Greg-R/t41_2_low_power_amplifier/README.md

The documentation for this module is located here:

<https://kf5n.com/t41-2/low_power_amplifier/>
