Greg-R/t41_2_low_power_amplifier/doc/t41_2_low_power_amplifier.pdf

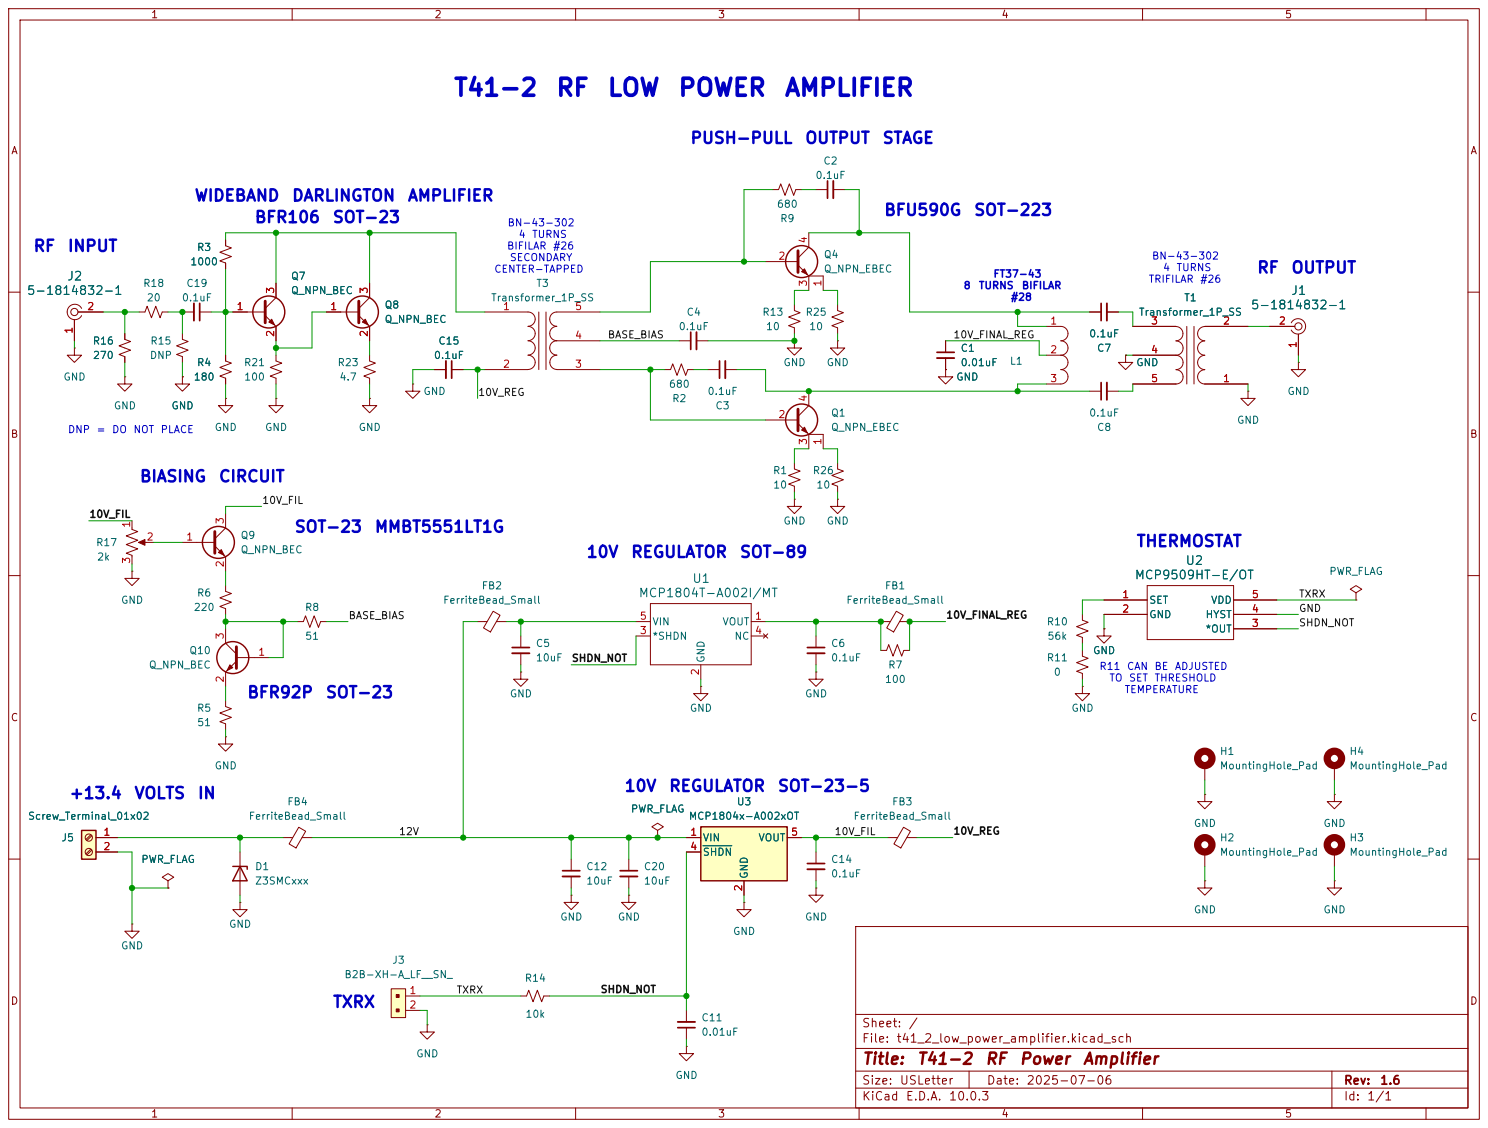
[picture p1: page 1]

T41-2 RF LOW POWER AMPLIFIER

PUSH-PULL OUTPUT STAGE
TXRX BN-43-302
4 TURNS
TRIFILAR #26

Sheet: /
File: t41_2_low_power_amplifier.kicad_sch
Title: T41-2 RF Power Amplifier

Size: USLetter | Rev: 1.6
KiCad E.D.A. 10.0.3 | Id: 1/1
