Greg-R/t41_2_low_power_amplifier/t41_2_low_power_amplifier.kicad_pcb

## KiCad design t41_2_low_power_amplifier.kicad_pcb (2026-07-03)

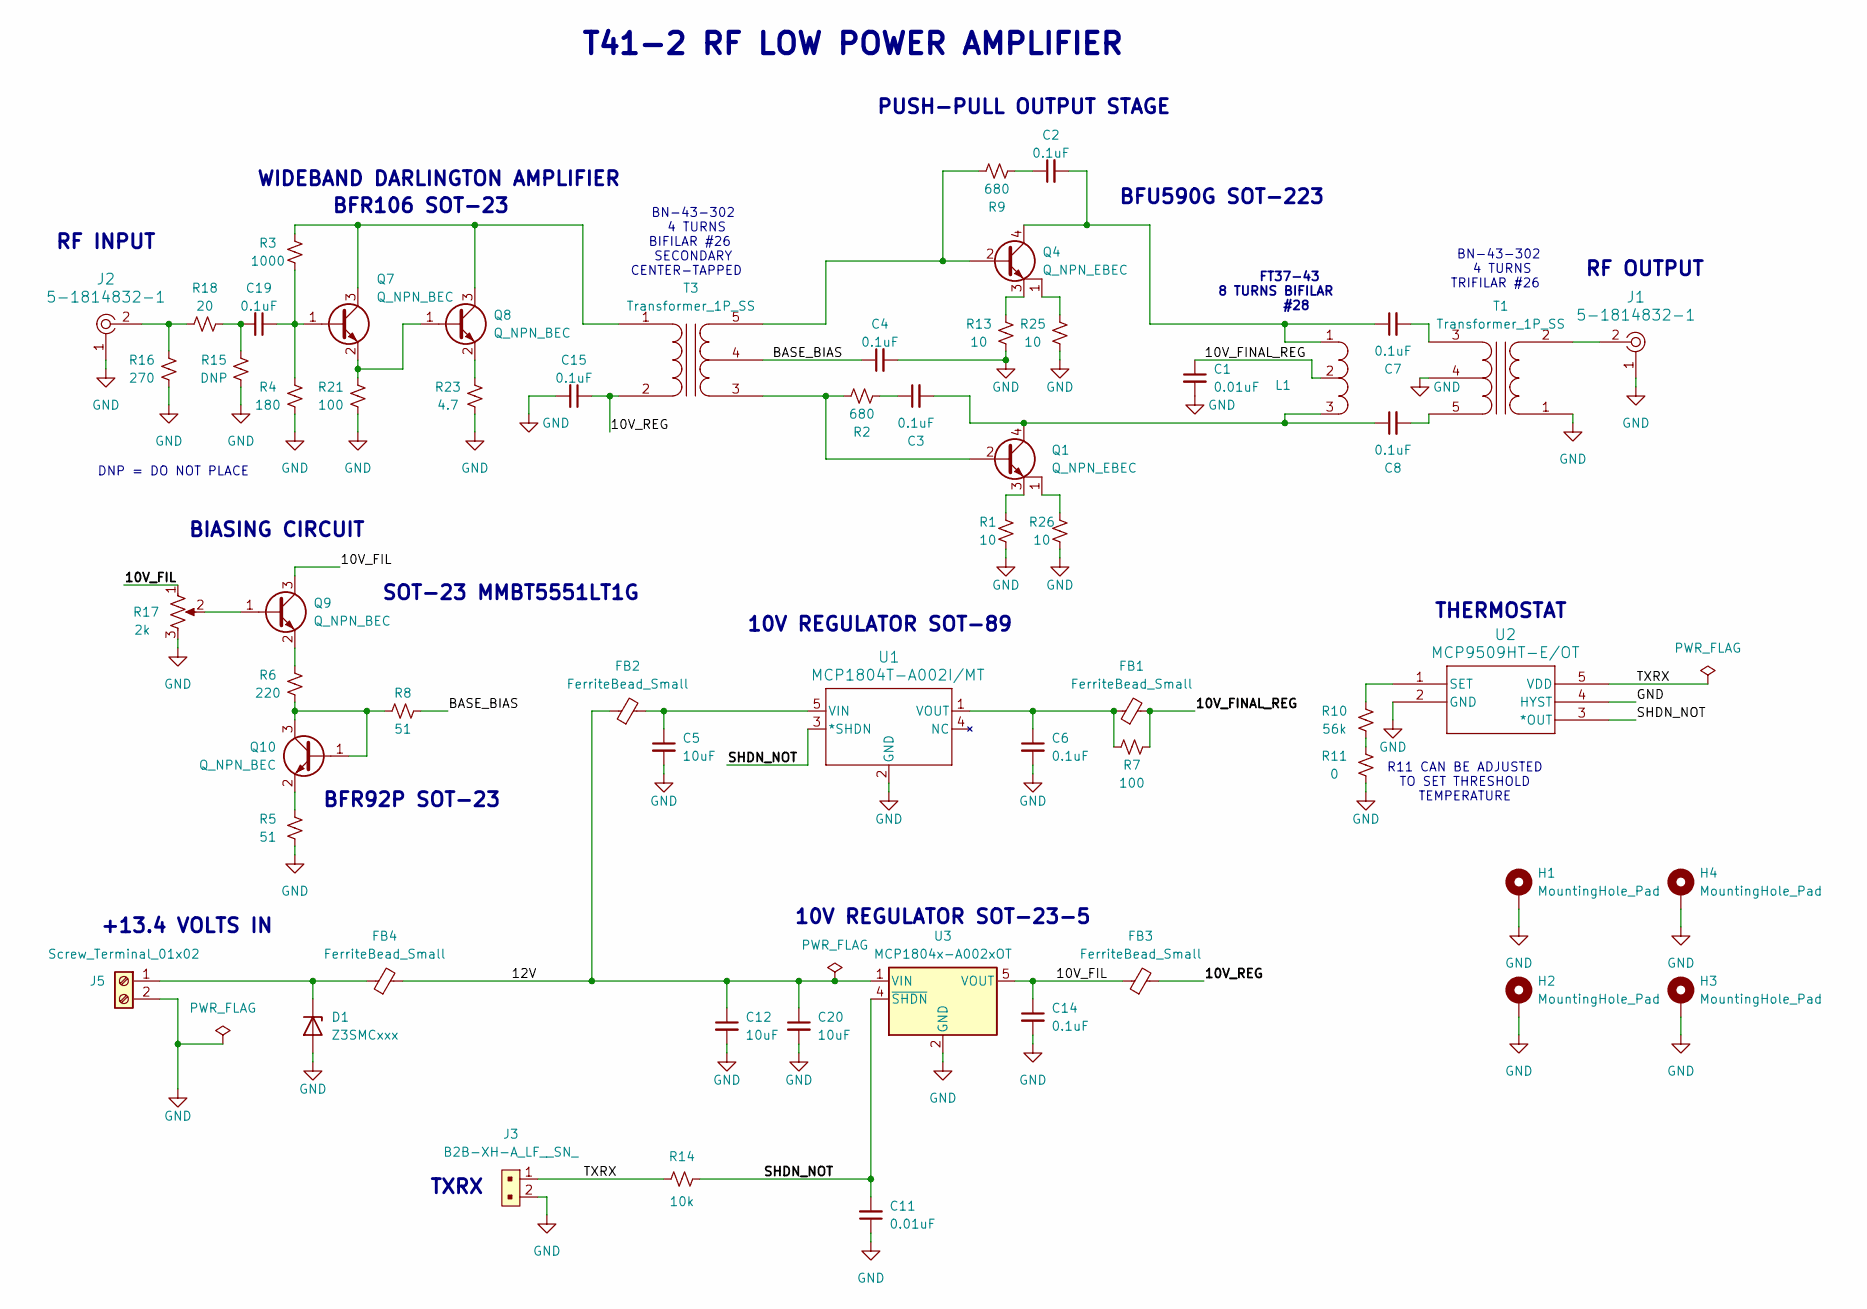
[picture p2: schematic t41_2_low_power_amplifier.kicad_sch, T41-2 RF Power Amplifier]

Parts:
C1, C11: 0.01uF; C_1206_3216Metric
C2, C3, C4, C6, C7, C8, C14, C15, C19: 0.1uF; C_1206_3216Metric
C5, C12, C20: 10uF; C_1206_3216Metric
D1: Z3SMCxxx; D_SMC
FB1, FB2, FB3, FB4: FerriteBead_Small; L_1206_3216Metric
H1, H2, H3, H4: MountingHole_Pad; MountingHole_4.3mm_M4_DIN965_Pad
J1, J2: 5-1814832-1; RF_SMA_Vertical_5-1814832-1; MPN 5-1814832-1; Digi-Key_PN A97594-ND
J3: B2B-XH-A_LF__SN_; PinHeader_1x2_P2.5mm_Drill1.1mm; MPN B2B-XH-A(LF)(SN); Digi-Key_PN 455-2247-ND
J5: Screw_Terminal_01x02; TerminalBlock_Philmore_TB132_1x02_P5.00mm_Horizontal
L1: FT37-43
Q1, Q4: Q_NPN_EBEC; SOT-223
Q7, Q8, Q9, Q10: Q_NPN_BEC; SOT-23-3
R1, R13, R25, R26: 10; R_1206_3216Metric
R2, R9: 680; R_1206_3216Metric
R3: 1000; R_1206_3216Metric
R4: 180; R_1206_3216Metric
R5, R8: 51; R_1206_3216Metric
R6: 220; R_1206_3216Metric
R7, R21: 100; R_1206_3216Metric
R10: 56k; R_1206_3216Metric
R11: 0; R_1206_3216Metric
R14: 10k; R_1206_3216Metric
R15: DNP; R_1206_3216Metric
R16: 270; R_1206_3216Metric
R17: 2k; Potentiometer_Bourns_3296W_Vertical
R18: 20; R_1206_3216Metric
R23: 4.7; R_1206_3216Metric
T1, T3: Transformer_1P_SS; BN-43-302_Vertical
U1: MCP1804T-A002I/MT; SOT-89_5MC_MCH
U2: MCP9509HT-E/OT; SOT-23-5_MC_MCH
U3: MCP1804x-A002xOT; SOT-23-5

Connections:
/10V_FIL: C14.1, FB3.1, Q9.3 (C), R17.1, U3.5 (VOUT)
/10V_FINAL_REG: C1.1, FB1.2, L1.2, R7.1
/10V_REG: C15.1, FB3.2, T3.2 (AB)
/12V: C12.1, C20.1, FB2.1, FB4.2, U3.1 (VIN)
/BASE_BIAS: C4.1, R8.1, T3.4 (SC)
/SHDN_NOT: C11.2, R14.2, U1.3 (*SHDN), U2.3 (*OUT), U3.4 (~SHDN)
/TXRX: J3.1, R14.1, U2.5 (VDD)
GND: C1.2, C4.2, C5.2, C6.2, C11.1, C12.2, C14.2, C15.2, C20.2, D1.2 (A), H1.1, H2.1, H3.1, H4.1, J1.1, J2.1, J3.2, J5.2, R1.1, R4.1, R5.1, R11.2, R13.1, R15.1, R16.1, R17.3, R21.1, R23.1, R25.1, R26.1, T1.1 (AA), T1.4 (SC), U1.2 (GND), U2.2 (GND), U2.4 (HYST), U3.2 (GND)
unnamed: C2.1, R9.1
unnamed: C3.1, R2.1
unnamed: C19.2, R15.2, R18.2
unnamed: D1.1 (K), FB4.1, J5.1
unnamed: J2.2, R16.2, R18.1
unnamed: Q1.2 (B), R2.2, T3.3 (SA)
unnamed: C3.2, C8.1, L1.3, Q1.4 (C)
unnamed: Q1.3 (E), R1.2
unnamed: Q1.1, R26.2
unnamed: Q4.2 (B), R9.2, T3.5 (SB)
unnamed: C2.2, C7.1, L1.1, Q4.4 (C)
unnamed: Q4.3 (E), R13.2
unnamed: Q4.1, R25.2
unnamed: C19.1, Q7.1 (B), R3.1, R4.2
unnamed: Q7.3 (C), Q8.3 (C), R3.2, T3.1 (AA)
unnamed: Q7.2 (E), Q8.1 (B), R21.2
unnamed: Q8.2 (E), R23.2
unnamed: Q9.1 (B), R17.2
unnamed: Q9.2 (E), R6.2
unnamed: Q10.1 (B), Q10.3 (C), R6.1, R8.2
unnamed: Q10.2 (E), R5.2
unnamed: R10.2, R11.1
unnamed: J1.2, T1.2 (AB)
unnamed: C7.2, T1.3 (SA)
unnamed: C8.2, T1.5 (SB)
unnamed: C5.1, FB2.2, U1.5 (VIN)
unnamed: C6.1, FB1.1, R7.2, U1.1 (VOUT)
unnamed: R10.1, U2.1 (SET)

Notes on the sheet:
RF OUTPUT
THERMOSTAT
PUSH-PULL OUTPUT STAGE
BN-43-302 4 TURNS TRIFILAR #26
R11 CAN BE ADJUSTED TO SET THRESHOLD TEMPERATURE
BFU590G SOT-223
BIASING CIRCUIT
SOT-23 MMBT5551LT1G
+13.4 VOLTS IN
TXRX
FT37-43 8 TURNS BIFILAR #28
DNP = DO NOT PLACE
T41-2 RF LOW POWER AMPLIFIER
BFR106 SOT-23
RF INPUT
10V REGULATOR SOT-23-5
BN-43-302 4 TURNS BIFILAR #26 SECONDARY CENTER-TAPPED
WIDEBAND DARLINGTON AMPLIFIER
BFR92P SOT-23
10V REGULATOR SOT-89

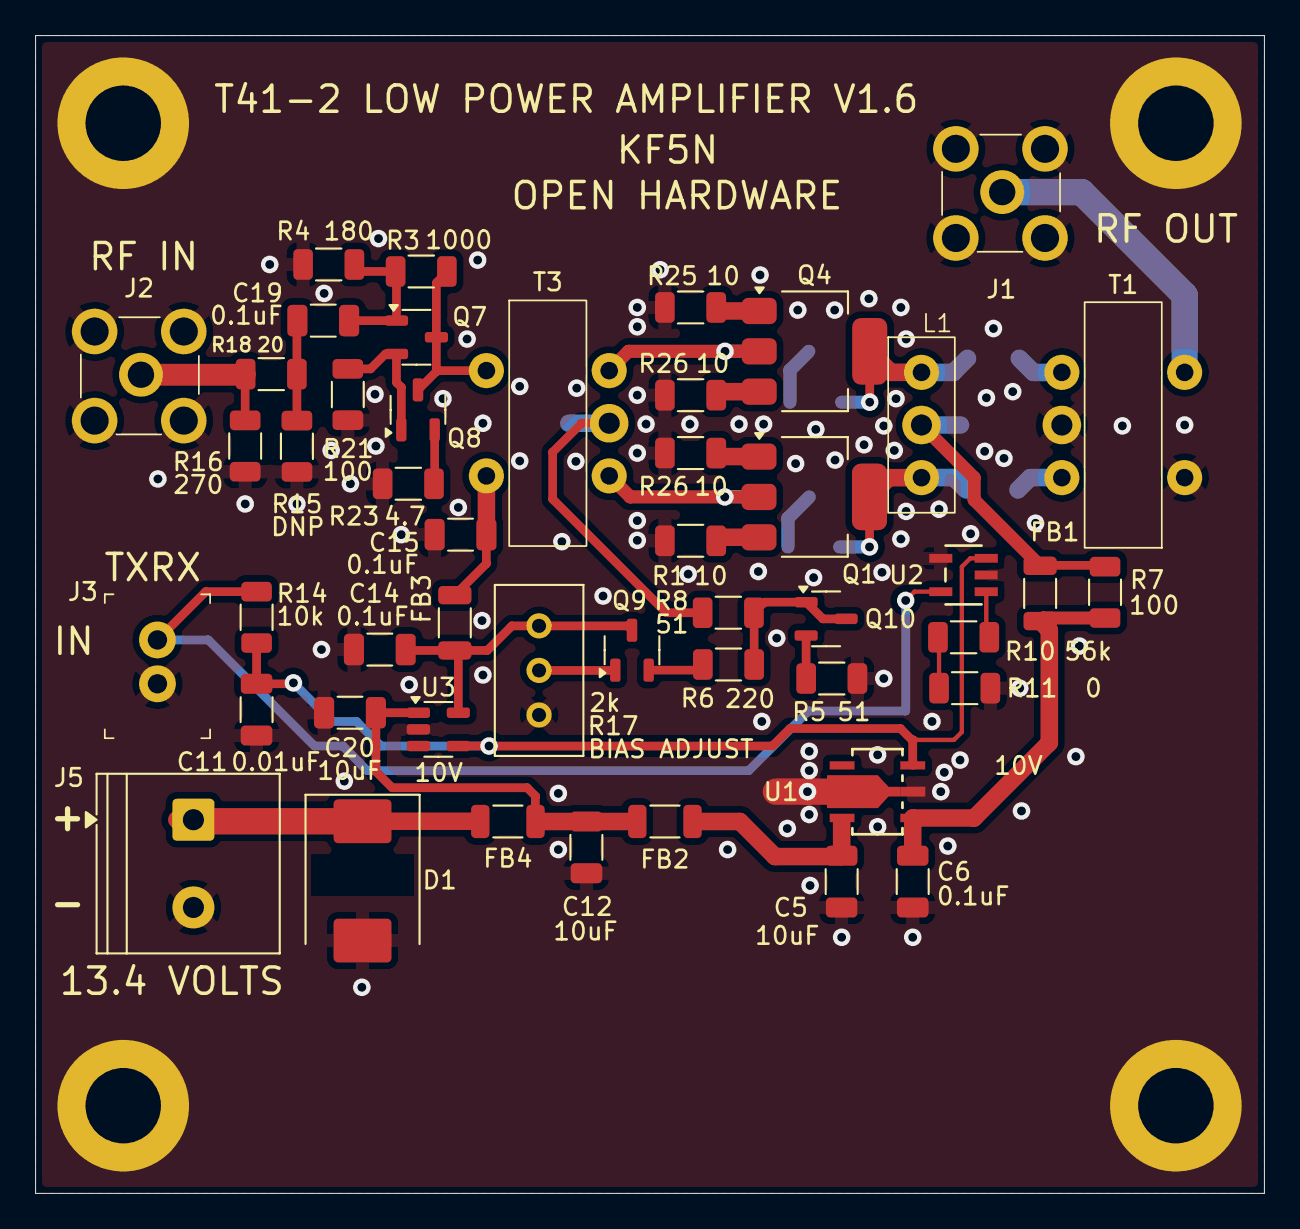
[picture p3: board t41_2_low_power_amplifier.kicad_pcb from above]

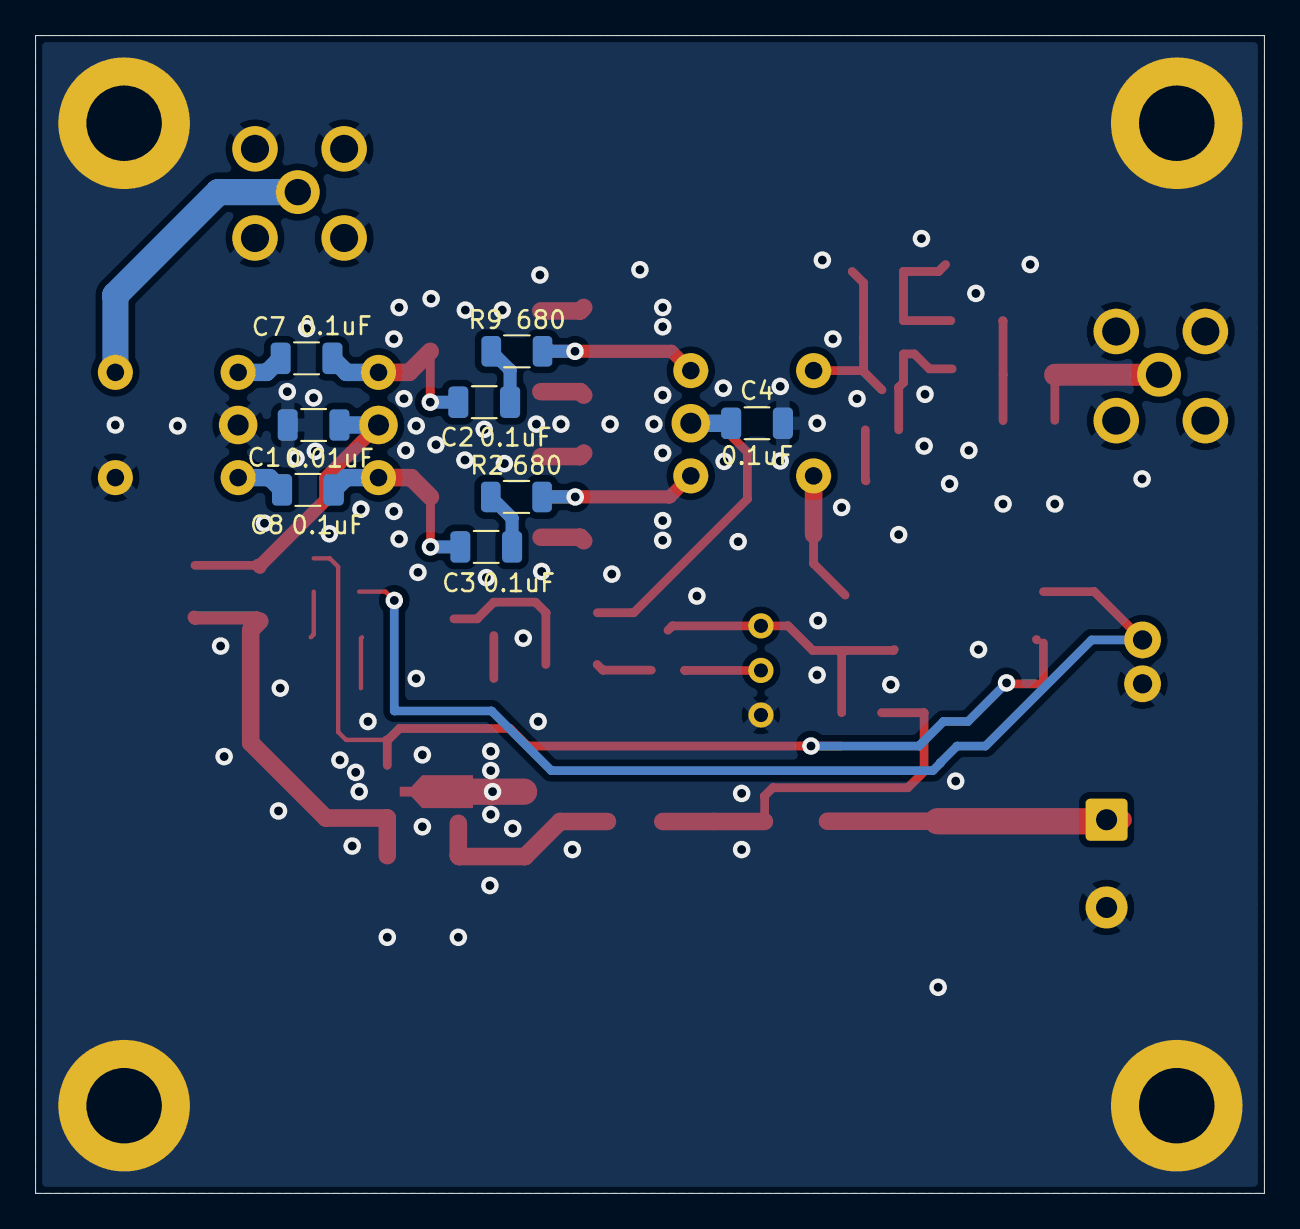
[picture p4: board t41_2_low_power_amplifier.kicad_pcb from below]

Board: 2 copper layers, 70.1 x 66.0 mm, 60 parts (8 on the bottom side), 36 nets.
