Greg-R/t41_2_low_power_amplifier/(commit log)

2024-11-08 Initial commit.
    [t41_2_low_power_amplifier-B_Cu.gbr, t41_2_low_power_amplifier-B_Mask.gbr, t41_2_low_power_amplifier-B_Silkscreen.gbr, t41_2_low_power_amplifier-Edge_Cuts.gbr, t41_2_low_power_amplifier-F_Cu.gbr, t41_2_low_power_amplifier-F_Mask.gbr, t41_2_low_power_amplifier-F_Silkscreen.gbr, t41_2_low_power_amplifier-NPTH.drl]
2024-11-11 First version complete and sent to fab.
    [t41_2_low_power_amplifier-B_Cu.gbr, t41_2_low_power_amplifier-B_Mask.gbr, t41_2_low_power_amplifier-B_Silkscreen.gbr, t41_2_low_power_amplifier-Edge_Cuts.gbr, t41_2_low_power_amplifier-F_Cu.gbr, t41_2_low_power_amplifier-F_Mask.gbr, t41_2_low_power_amplifier-F_Silkscreen.gbr, t41_2_low_power_amplifier-NPTH.drl]
2024-11-30 Most routing completed.
    [t41_2_low_power_amplifier.kicad_pcb, t41_2_low_power_amplifier.kicad_sch]
2024-12-01 Low Power Amplifier ready for fab.
    [t41_2_low_power_amplifier-B_Cu.gbr, t41_2_low_power_amplifier-B_Mask.gbr, t41_2_low_power_amplifier-B_Silkscreen.gbr, t41_2_low_power_amplifier-Edge_Cuts.gbr, t41_2_low_power_amplifier-F_Cu.gbr, t41_2_low_power_amplifier-F_Mask.gbr, t41_2_low_power_amplifier-F_Silkscreen.gbr, t41_2_low_power_amplifier-NPTH.drl]
2024-12-22 T41-2 Low Power Amplifier to fab.
    [t41_2_low_power_amplifier-B_Cu.gbr, t41_2_low_power_amplifier-B_Mask.gbr, t41_2_low_power_amplifier-B_Silkscreen.gbr, t41_2_low_power_amplifier-Edge_Cuts.gbr, t41_2_low_power_amplifier-F_Cu.gbr, t41_2_low_power_amplifier-F_Mask.gbr, t41_2_low_power_amplifier-F_Silkscreen.gbr, t41_2_low_power_amplifier-NPTH.drl]
2025-01-19 Low Power Amplifier to fab.
    [t41_2_low_power_amplifier-B_Cu.gbr, t41_2_low_power_amplifier-B_Mask.gbr, t41_2_low_power_amplifier-B_Silkscreen.gbr, t41_2_low_power_amplifier-Edge_Cuts.gbr, t41_2_low_power_amplifier-F_Cu.gbr, t41_2_low_power_amplifier-F_Mask.gbr, t41_2_low_power_amplifier-F_Silkscreen.gbr, t41_2_low_power_amplifier-NPTH.drl]
2025-04-23 Release to fab.
    [t41_2_low_power_amplifier-B_Cu.gbr, t41_2_low_power_amplifier-B_Mask.gbr, t41_2_low_power_amplifier-B_Silkscreen.gbr, t41_2_low_power_amplifier-Edge_Cuts.gbr, t41_2_low_power_amplifier-F_Cu.gbr, t41_2_low_power_amplifier-F_Mask.gbr, t41_2_low_power_amplifier-F_Silkscreen.gbr, t41_2_low_power_amplifier-NPTH.drl]
2025-05-05 Updated notes on schematic.
    [t41_2_low_power_amplifier.kicad_sch]
2025-05-05 Updated schematic notes.
    [t41_2_low_power_amplifier.kicad_pcb, t41_2_low_power_amplifier.kicad_sch]
2025-06-16 Finishing up version 1.5. Not ready for fab.
    [t41_2_low_power_amplifier-B_Cu.gbr, t41_2_low_power_amplifier-B_Mask.gbr, t41_2_low_power_amplifier-B_Silkscreen.gbr, t41_2_low_power_amplifier-Edge_Cuts.gbr, t41_2_low_power_amplifier-F_Cu.gbr, t41_2_low_power_amplifier-F_Mask.gbr, t41_2_low_power_amplifier-F_Silkscreen.gbr, t41_2_low_power_amplifier-NPTH.drl]
2025-06-23 Added Chernobyl device.
    [t41_2_low_power_amplifier.kicad_pcb, t41_2_low_power_amplifier.kicad_sch]
2025-06-23 Ready for fab.
    [t41_2_low_power_amplifier-B_Cu.gbr, t41_2_low_power_amplifier-B_Mask.gbr, t41_2_low_power_amplifier-B_Silkscreen.gbr, t41_2_low_power_amplifier-Edge_Cuts.gbr, t41_2_low_power_amplifier-F_Cu.gbr, t41_2_low_power_amplifier-F_Mask.gbr, t41_2_low_power_amplifier-F_Silkscreen.gbr, t41_2_low_power_amplifier-NPTH.drl]
2025-07-05 Clean up for publish.
    [t41_2_low_power_amplifier-B_Cu.gbr, t41_2_low_power_amplifier-B_Mask.gbr, t41_2_low_power_amplifier-B_Silkscreen.gbr, t41_2_low_power_amplifier-Edge_Cuts.gbr, t41_2_low_power_amplifier-F_Cu.gbr, t41_2_low_power_amplifier-F_Mask.gbr, t41_2_low_power_amplifier-F_Silkscreen.gbr, t41_2_low_power_amplifier-NPTH.drl]
2025-07-06 Added preliminary README file.
    [t41_2_low_power_amplifier.kicad_sch]
2026-05-23 Minor schematic update.
    [t41_2_low_power_amplifier.kicad_sch]
2026-07-03 Corrected mistake in back silkscreen.
    [t41_2_low_power_amplifier.kicad_pcb]
